elymsyr/mysterychain/interfaces/watch/README.md

# Watch (device firmware)

One Arduino sketch for the keychain's round display: [`firmware/firmware.ino`](firmware/firmware.ino). The scene is a header next to it, picked by the `#include` line near the top of the sketch. The default, [`pets.h`](firmware/pets.h), holds all three pets (cat, Pavi, Nausicaa) and lets the phone switch between them (`#set scene`, the app's settings); the choice is saved on the board.

| Scene header | What happens |
| --- | --- |
| [`cat.h`](firmware/cat.h) | Pixel cat on a lawn. Shake: the yarn ball flies, the cat jumps and plays for 6 s. The cat is also a pet, see [Pets](#pets). |
| [`pavi.h`](firmware/pavi.h) | Pavi (Seven Havens) on a wall above the rooftops: clouds and sun by day, aurora, moon and stars at night. Shake: her fairy darts off and she chases it. Pavi is also a pet, see [Pets](#pets). |
| [`nausicaa.h`](firmware/nausicaa.h) | Nausicaa in a windy valley with Teto on her shoulder. Shake: Teto jumps off, she tries to catch him, then kneels and he climbs back. |

Every scene behaves the same way (screens: [docs/mockups/device_screens.png](../../docs/mockups/device_screens.png)):

- 80×80 pixel scene, scaled 3× to the 240×240 display over SPI DMA, ~30 fps. Motion is tied to real time, so speed holds if fps drops.
- **BLE** (Nordic UART, name `MysteryChain`): text from the [mobile app](../mobile-app/) scrolls in a speech bubble at the top, the motor buzzes twice, the character cheers. Messages starting with `#` are commands, see [protocol](#protocol).
- **Clock:** the app sends the phone's time on every connect. Kept until power-off; after that it's back on the next connect.
- **Button** (D0): the character cheers, motor buzzes once, `button N` is sent to the phone. Once the clock is set, a tap also shows the time (`14:32`) in the bubble for 3 s.
- **Find** (`#find`): `FIND ME!` in the bubble, the motor buzzes twice and pauses, the screen colors invert twice a second. A button press stops it and sends `found`; `#find 0` stops it from the app; after `FIND_MS` (60 s) it stops by itself and sends `find timeout`. Shakes are ignored while it runs.
- **Power** (button in firmware; the battery switch on the back stays on): hold the button 3 s to turn off (display cut by Q2 on D7, System OFF, a few µA). Hold ~1 s to turn on; a short tap leaves it off. Plugging in USB also turns it on, so uploads work with the case closed. Waking is a reset: the scene starts over.
- **Screen off:** no button for 20 s (pets: 30 s, 1 or 5 min, `#set screen`): the display goes dark (Q2 cut), BLE stays up. Motion never keeps it lit: a keychain moves all day, and in the pocket it kept the screen on. What wakes it (pets: `#set wake`, any of button / shake / lift; other scenes: the button): shake is the IMU's wake-up function over the shake threshold, lift its tilt function (> 35°), both latched and checked every dark loop (up to `DARK_WAIT_MS` late); either one also fires in a moving pocket. Dark, the board sleeps up to `DARK_WAIT_MS` (1 s) at a time, the button wakes it at once, the accelerometer drops to 26 Hz low power (the pedometer still counts; no shakes or petting while dark), and it asks the phone for slave latency (`BLE_DARK_LATENCY`), so the radio wakes ~every 240 ms instead of 30. The button or `#find` brings it back. Turned off with the button, only the button turns it on (IMU unpowered in System OFF).
- **Radio:** −4 dBm. Unconnected, it advertises every 20 ms for 30 s, then every 1 s.
- **Battery** ([`battery.h`](firmware/battery.h)): a gauge at the bottom of the screen for `CLOCK_MS` after a tap, always while on USB (bolt; yellow and filling = charging, green and full = done) or below 15 % (red). The level comes from a LiPo curve, read every 5 s, not during a buzz. Without USB below `VBAT_OFF_MV` (3.4 V) it turns itself off; the button turns it on again only to go off once more until it's charged. PC check: `g++ -std=c++17 -I firmware test/battery_test.cpp -o /tmp/battery_test && /tmp/battery_test /tmp/battery.ppm` (the `.ppm` shows the four looks).
- **Shake** (IMU): the scene reacts, `shake N (x.xx g)` is sent to the phone. Shakes are ignored for `MOTOR_MASK_MS` after the motor stops.
- Serial monitor prints fps once a second.

## Pets

With `cat.h` or `pavi.h` the character lives on its own: stats, moods, day and night, a runner game, a music screen. Both have the same set of animations, each in its own way (below: cat / Pavi). Screens: [day and night](../../docs/mockups/pet_day_night.png), [animations](../../docs/mockups/pet_animations.png), [game](../../docs/mockups/pet_game.png); every animation as a clip: [preview](#preview).

- **Stats** ([`pet.h`](firmware/pet.h)): fullness, happiness, energy, 0–100, kept on the board only to pick the animations (not shown anywhere). Fullness empties in 10 h (half as fast asleep), happiness in 16 h awake (twice as fast when starving), energy in 16 h awake and refills in 8 h of sleep. Messages and reactions +8 (once a minute), petting +5, 100 steps +1, a game up to +15 and −10 energy. The pet never dies.
- **Mood**, first that holds: `sleep` (night window or energy < 10), `hungry` (< 25), `sad` (< 25), `tired` (< 25), `happy`. Asleep: curled up with z's / hugging her knees, the fairy dozing on her head. Hungry: by an empty bowl / plate. Sad: lies down / sits with her head down. Tired: yawns. Happy: now and then a butterfly (day) or a mouse / firefly (night) comes by and gets chased; every 10–25 s an idle trick: grooming or a tail chase / a wave, sitting with her feet tapping, or a twirl.
- **Button:** tap = clock + cheer (after 300 ms); double tap = feed (after 300 ms with `pets.h`); triple tap (`pets.h`) = next character, its name in the bubble (eats from the bowl / an apple, or shakes the head when fullness > 90); hold until the 1 s buzz and release = runner game; hold 3 s = off.
- **Music screen:** while the phone plays music (`#music`), the whole background turns into the character's own gradient (cat: peach to plum, Pavi: pink to violet), the title scrolls across the top and the character dances to a 120 bpm beat, notes rising. No buzz. It stays while the music plays; paused (`#music 0`) the title stays and the dancing stops for `MUSIC_PAUSE_MS` (60 s), then it's gone (also when the link drops). On it the button is a media key: tap = play/pause (`media toggle`), double tap = next track (`media next`); triple tap, hold and the 3 s off work as usual. A message or the clock shows over it for its time, find and the game end it, a shake is a hop and back to dancing. Asleep, the pet sleeps on.
- **Runner game:** tap = jump over a flower pot, hold = high jump over a fence, stay down under birds (from 20 points). Score and best in the bubble; a new best buzzes 3 times. Each character keeps its own best (the app shows them and resets them). After a game over a press restarts, 10 s idle or a 3 s hold leaves (no power-off inside the game). Not with energy < 15.
- **Pavi's game** (instead of the runner): the travel road, seen from behind her. Tilt the keychain right / left = right / left lane, level = middle; the button isn't used. One hit and it's over, score = obstacles passed, faster every 5 points. Tilt axis and sign: `TILT_AXIS` / `TILT_SIGN` in `firmware.ino` (check on the device), thresholds `TILT_IN` / `TILT_OUT` in `pavi.h`.
- **Nausicaa's game** (instead of the runner): an air fight on the Mehve, seen from above, the valley (fields, a river, woods) rolling under her. Tilt sets where she flies along the bottom (level = middle, `TILT_FULL` 0.5 g = the edge); the button fires, held = auto-fire. Every shot heats the gun (bar under her: green, amber, red); full heat jams it, blinking, until it has cooled all the way (~1.4 s). Planes from the top: Pejite gunships (red, weaving, ram you, 1 hit), Tolmekian armored corvettes (four wings, aimed shots, 3 hits, from 5 points), Bumblecrow transports (huge, 3-way spread, 8 hits, from 15 points). A bullet or a crash ends it; a downed plane scores its hits. Her shots end at the bubble's lower edge, so every fight is in view. Tunables at the game section of `nausicaa.h`.
- **Gandalf and Sauron** ([`gandalf.h`](firmware/gandalf.h), [`sauron.h`](firmware/sauron.h)) are full pets too, with the same moods and events. Gandalf: asleep standing on his staff, nodding, z's; hungry: peers into an empty tankard and shakes the last drop out; sad: head down, sighing; tired: yawns; fed: drinks an ale (foam moustache); full: waves it off, shaking his head; petted: chuckles. Music screen: he rides Shadowfax across Rohan (side on, parallax peaks / downs / road, dust from the hooves; shake = a leap, tap = the staff lights). Sauron: asleep, the Eye on the tower shut and the visor down to embers; hungry: holds up an empty goblet, drums his mace; sad: the Eye dims, smoke sighs from the visor; fed: a goblet of lava to the visor; full: waves it away; petted: a laugh, the visor flashing. Music screen: he flies a fell beast over Gorgoroth (ash clouds, the Ephel Dúath, smoking cones, lava cracks, Barad-dûr passing far off; shake = a climb, tap = the beast shrieks). Both set off on a ride / flight of their own now and then when happy. Their games: the Bridge of Khazad-dûm / the Ring's maze (see the headers). Clips: [`test/lotr_preview.cpp`](test/lotr_preview.cpp) (`-DSAURON`).
- **Petting:** double tap on the case (IMU tap engine): hearts and a soft purr buzz. A shake waits 300 ms so a double tap isn't taken as a shake.
- **Steps:** the IMU's hardware pedometer; today's count resets at local midnight. Off = no counting.
- **Day and night:** sky, ground, clouds, sun and moon follow the clock (dawn 06–08, day, sunset 18–20, night; keyframes in `pet.h`, colors per scene in its `LOOK` table). Pavi: the aurora and stars fade in at night, her rooftops fade into the haze by day and their windows light up in the evening. No clock yet: night look.
- **Weather** (`#weather`, the phone's forecast for the next 4 hours; drawn by [`weather.h`](firmware/weather.h), shared by the three): clear, cloudy, wind, rain, snow or storm. The sky greys over and fills with clouds (wind: they race), the stars, aurora, sun and moon go behind them; rain and snow fall, snow settles on the ground (roofs, ridges), a storm sends a bolt with one 0.08 s flash every 4–10 s (never a strobe). The pets follow it, cat / Pavi / Nausicaa:
  - rain: sits under a planted umbrella / holds a water dome over herself, the fairy inside / sits under a big leaf;
  - snow: paws at the flakes and leaps / catches one and it sparkles / catches them, or Teto leaps off to play in the snow;
  - clear and the sun up: sunbathes in shades / sits in the sun, eyes shut (both);
  - wind: a blown leaf comes by instead of a butterfly, tail / ponytail / hair stream out, squinting in a gust; Pavi's fairy fights the gusts, Nausicaa's windmills spin fast and she reads the wind more often;
  - thunder startles them (puffed up / hands to the head, Teto hides in her tunic); asleep, one eye opens.
  The clock tap shows the weather's icon left of the time. No new forecast for `WX_MS` (4 h): unknown again (clear look, no icon). The games have no weather.
- **Night window** (default 23–07): the pet sleeps and the motor is quiet, except for find.
- **Saved** in the internal flash (`/pet`, LittleFS) every 10 min and on feed, settings, a new best and power-off. Time spent off counts as sleep (up to 48 h) once the phone sends the time.

## Flash

Arduino IDE 2 with **Seeed nRF52 Boards** (non-mbed), board **Seeed XIAO nRF52840 Sense**, libraries **Adafruit GC9A01A** and **Seeed Arduino LSM6DS3**. Full setup: [electronics/bring-up.md](../../electronics/bring-up.md#phase-0-tools-and-software).

Open `firmware/firmware.ino`, upload (to flash a single scene instead, set it in the `#include` line). Or with arduino-cli:

```bash
arduino-cli compile --fqbn Seeeduino:nrf52:xiaonRF52840Sense --upload -p /dev/ttyACM0 firmware
```

Tunables at the top of `firmware.ino`:

| Constant | Default | Meaning |
| --- | --- | --- |
| `SPI_HZ` | 32 MHz | Display clock. Drop to 16 MHz (~17 fps) if the image glitches. |
| `SHAKE_G` | 0.5 | Shake threshold: deviation of \|a\| from 1 g |
| `SHAKE_GAP_MS` | 400 | Minimum time between two shakes |
| `MOTOR_MASK_MS` | 400 | Shake blackout after the motor stops. Use the value measured in bring-up T8. |
| `ON_HOLD_MS` / `OFF_HOLD_MS` | 1000 / 3000 | Button hold to turn on / off |
| `IDLE_OFF_MS` | 20000 | Screen off after this long without the button (pets: `#set screen` instead) |
| `DARK_WAIT_MS` | 1000 | Screen off: longest sleep between loops (the button wakes it sooner) |
| `BLE_DARK_LATENCY` | 7 | Screen off: 30 ms connection events the radio may skip |
| `CLOCK_MS` | 3000 | How long a button tap shows the time |
| `MUSIC_PAUSE_MS` | 60000 | Pets: paused music keeps its screen this long, so a tap can resume it |
| `FIND_MS` | 60000 | Find stops by itself after this long |
| `GAME_HOLD_MS` | 1000 | Pets: hold and release after this long = game |
| `TAP_WAIT_MS` | 300 | Pets: a tap waits this long for a second one (double = feed) |
| `SHAKE_WAIT_MS` | 300 | Pets: a shake is decided this late; a case double tap inside it is petting |
| `TAP_GUARD_MS` | 500 | Pets: case taps this soon after a button edge are ignored |
| `TAP_THS` | 1 | Pets: IMU tap threshold, × 0.5 g. Check through the printed case |
| `SAVE_S` | 600 | Pets: stats saved this often |
| `WX_MS` | 4 h | Pets: a forecast (`#weather`) is dropped this long after it came |

Stat rates and gains are at the top of [`pet.h`](firmware/pet.h), game physics at the top of [`game.h`](firmware/game.h).

## Protocol

Plain UTF-8 text over Nordic UART. A message ends at a line break (the app sends one), or 150 ms after its last byte for senders without one, so a write split into 20-byte packets on a small MTU still arrives as one message. A message the board doesn't recognise as a command shows in the bubble, so plain text, and text that only looks like a command (`#1 fan`), keeps working.

| Phone → keychain | Effect |
| --- | --- |
| any text | Bubble (max 63 characters; Turkish letters folded to ASCII, other non-ASCII shows as `?`), buzz twice, cheer |
| `#time <unix s> <utc offset min>` | Set the clock. The app sends it on every connect. |
| `#find` / `#find 0` | Start / stop find |
| `#heart` | Three pink hearts in the bubble, buzz twice, cheer |
| `#call <caller>` / `#call 0` | A call rings: caller in the bubble, ring buzz (0.4 s every second) / answered or gone: bubble and buzz stop. Stops by itself after `CALL_MS` (45 s). Sent by the app's background link. |
| `#music <title - artist>` / `#music 0` | A track plays / music paused or stopped: pets show the [music screen](#pets) while it plays, other scenes ♫ and the text in the bubble. No buzz. Sent by the app's background link on every change and on connect. |
| `#weather clear\|cloudy\|wind\|rain\|snow\|storm` | Pets: the weather for the next hours ([pets](#pets)); anything else (`#weather 0`) = unknown. Not saved; dropped after `WX_MS`. The app sends it on connect and every hour. |
| `#feed` | Pets: feed (answers `fed` or `full`) |
| `#stats` | Pets: send `stats` now |
| `#set vib 0\|1` | Pets: motor off / on (find always buzzes) |
| `#set shake <g>` | Pets: shake threshold, 0.3–1.0 |
| `#set screen 30\|60\|300` | Pets: screen off after this many s without the button |
| `#set wake <bits>` | Pets: what wakes the dark screen, 1 button + 2 shake + 4 lift (1–7) |
| `#set night <from h> <to h>` | Pets: night window (sleep + quiet); `from == to` = none |
| `#set name <look> <text>` | `pets.h`: that look's own name, up to 12 characters (defaults `Cat`, `Pavi`, `Nausicaa`); a single-scene build takes `#set name <text>` |
| `#set scene cat\|pavi\|nausicaa` | `pets.h`: the pet's look, at once and saved. Stats are shared, each look has its own name and high score; a running game ends |
| `#set best <look>\|all` | Pets: that look's high score (or all of them) back to 0 |

| Keychain → phone | When |
| --- | --- |
| `button N` | Button pressed (N counts since boot) |
| `shake N (x.xx g)` | Shake detected |
| `found` | Button pressed during find |
| `media toggle` / `media next` | Pets: button tap / double tap on the music screen; the app plays/pauses or skips the playing session |
| `find timeout` | Find stopped by itself after `FIND_MS` |
| `stats <steps> <mood> <battery %>` | Pets: after `#time`, on `#stats`, after a feed, and once a minute if a value changed; battery -1 = on USB |
| `settings vib=<0\|1> shake=<g> night=<from>-<to> screen=<s> wake=<bits> scene=<look> name=<cat>\|<pavi>\|<nausicaa>` | Pets: after `#time` and every `#set`; one name per look in `pets.h` order (a single-scene build sends one) |
| `fed` / `full` | Pets: answer to a feed (button or app) |
| `best <cat>\|<pavi>\|...` | Pets: right after every `settings`; each look's high score in `pets.h` order (a single-scene build sends one) |
| `game <score> best <best>` | Pets: game over |

## Scene interface

Each scene header (`cat.h`, `pavi.h`, `nausicaa.h`) is plain C++ with no Arduino dependency, so it can be compiled on a PC and dumped frame by frame. It lives in its own namespace, ends with `namespace scene = <its namespace>;` (the sketch only talks to `scene::`) and exposes:

| Name | Purpose |
| --- | --- |
| `N`, `fb[N*N]` | Scene size and the color-indexed framebuffer |
| `PAL[NCOL][3]`, `NCOL` | RGB palette |
| `INK`, `CREAM` | Palette indices used by the speech bubble |
| `px(x, y, c)` | Set one pixel (clipped) |
| `init()` | Draw the static background |
| `step(dt)` | Advance by `dt` seconds and redraw `fb` |
| `shake()` | React to a shake |
| `cheer()` | React to a message or button press |

To add a scene, put its header in `firmware/` with the same interface and the `namespace scene = …;` line, and include it from `firmware.ino`. The sketch adds four palette entries after the scene's own: `NCOL` pink for the hearts, `NCOL + 1..3` the weather icon's grey, blue and yellow.

A scene that ends with `#define SCENE_PET` (`cat.h`, `pavi.h`) turns on the pet code in the sketch and also exposes: `PAL` writable plus `tint(minuteOfDay)`, `setMood()`, `eat()`, `refuse()`, `purr()`, `yawn()`, `music(on)` (called every frame), and the game (`game`, `gameStart()`, `gameInput(held)`, `gameTilt(g)`, `gameStop()`, `gameLabel()`). Stats and the time-of-day keyframes live in [`pet.h`](firmware/pet.h); the runner in [`game.h`](firmware/game.h), included by the cat (Pavi and Nausicaa have their own tilt games in their headers) (its header lists what a scene defines for it: the `hero`, its head span, the bird height). PC check for both, with either runner:

```bash
g++ -std=c++17 -I firmware test/pet_test.cpp -o /tmp/pet_test && /tmp/pet_test
g++ -std=c++17 -DPAVI -I firmware test/pet_test.cpp -o /tmp/pet_test && /tmp/pet_test
g++ -std=c++17 -DPETS -I firmware test/pet_test.cpp -o /tmp/pet_test && /tmp/pet_test   # pets.h look switch
```

[`pets.h`](firmware/pets.h) includes the three pet headers (they skip their `namespace scene` alias when `SCENE_PICK` is defined) and is itself the `scene`: `fb`, `PAL`, `NCOL`, `INK`, `CREAM` point at the current look, the calls go to it, `pick(i)` switches. The runner state is one object for all (`pet::runner`).

### Preview

[`test/preview.cpp`](test/preview.cpp) runs a pet scene on the PC and dumps a clip of every animation (times of day, music screen, moods, visitors, idle tricks, every weather `wx_*` and the clock icons, the game on autopilot); [`test/preview.py`](test/preview.py) turns them into round-masked GIFs. Look at them before flashing:

```bash
cd test
g++ -std=c++17 -O2 -I../firmware -I ~/Arduino/libraries/Adafruit_GFX_Library preview.cpp -o /tmp/preview_cat   # -DPAVI, -DNAUSICAA
mkdir -p /tmp/clips && /tmp/preview_cat /tmp/clips && python3 preview.py /tmp/clips /tmp/gifs   # --sheet: contact sheets too
python3 gallery.py [cat pavi nausicaa gandalf sauron]   # all of the above for every character, one page in the browser
```

## Rules for new animations

1. Existing behaviors stay as they are (cat `IDLE` / `RUN` / `CROUCH` / `JUMP` / `LAND` / `BAT`, Pavi and the fairy, yarn physics, `shake()` and `cheer()` reactions). New animations are added next to them, for both pets.
2. For every animation, write down when it starts, how long it lasts, which state it returns to and which events interrupt it.
3. Animations read the pet stats (hunger, happiness, energy) to pick what to play, and change them (eating lowers hunger, play costs energy). See [roadmap](../../docs/roadmap.md) K1.
4. They follow the time of day and weather backgrounds; characters and props must stay readable on every background, including night colors. At night the default is sleep.
5. Events can interrupt any animation: message/notification bubble, "find" command, shake, petting, button. A sleeping pet wakes up when shaken.
6. Motion uses `dt`, never frame counts.
7. Logic and drawing stay separate: stats and clock keep running while the display is off; drawing only happens when it's on.
8. Limits: 80×80 indexed buffer with the scene palette, ~30 fps target, the top band (y 11–24) is reserved for the speech bubble, corners are invisible on the round screen.
