elymsyr/mysterychain/electronics/schematic/schematic_pnp_white.png

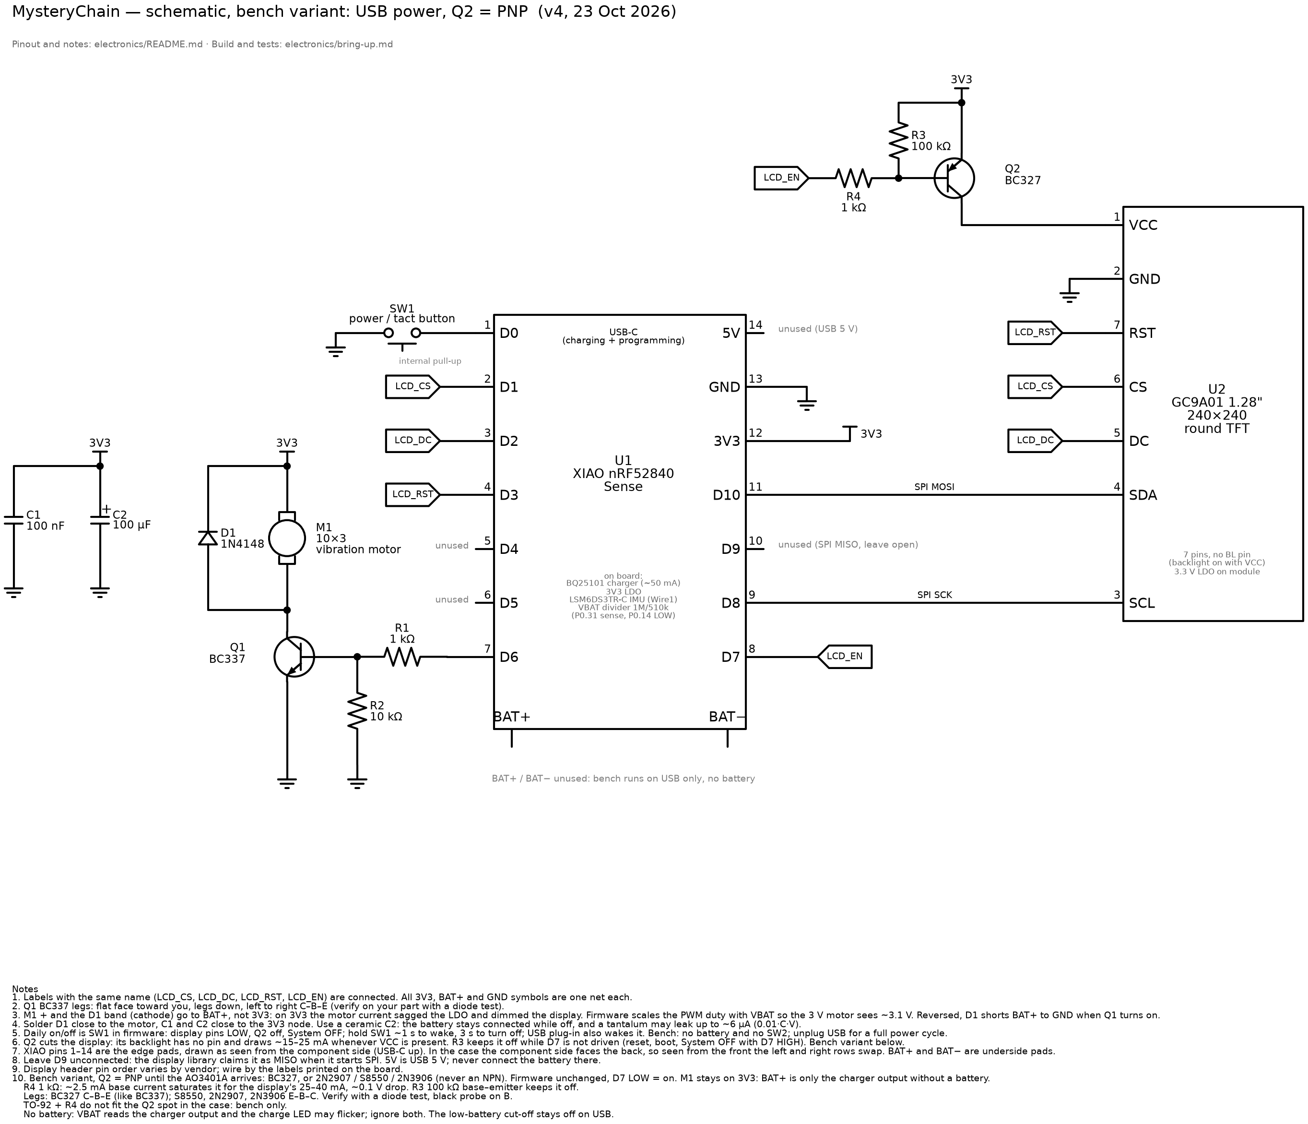
electronics/schematic/schematic_pnp_white.png
