elymsyr/mysterychain/electronics/schematic/schematic_proto_white.png

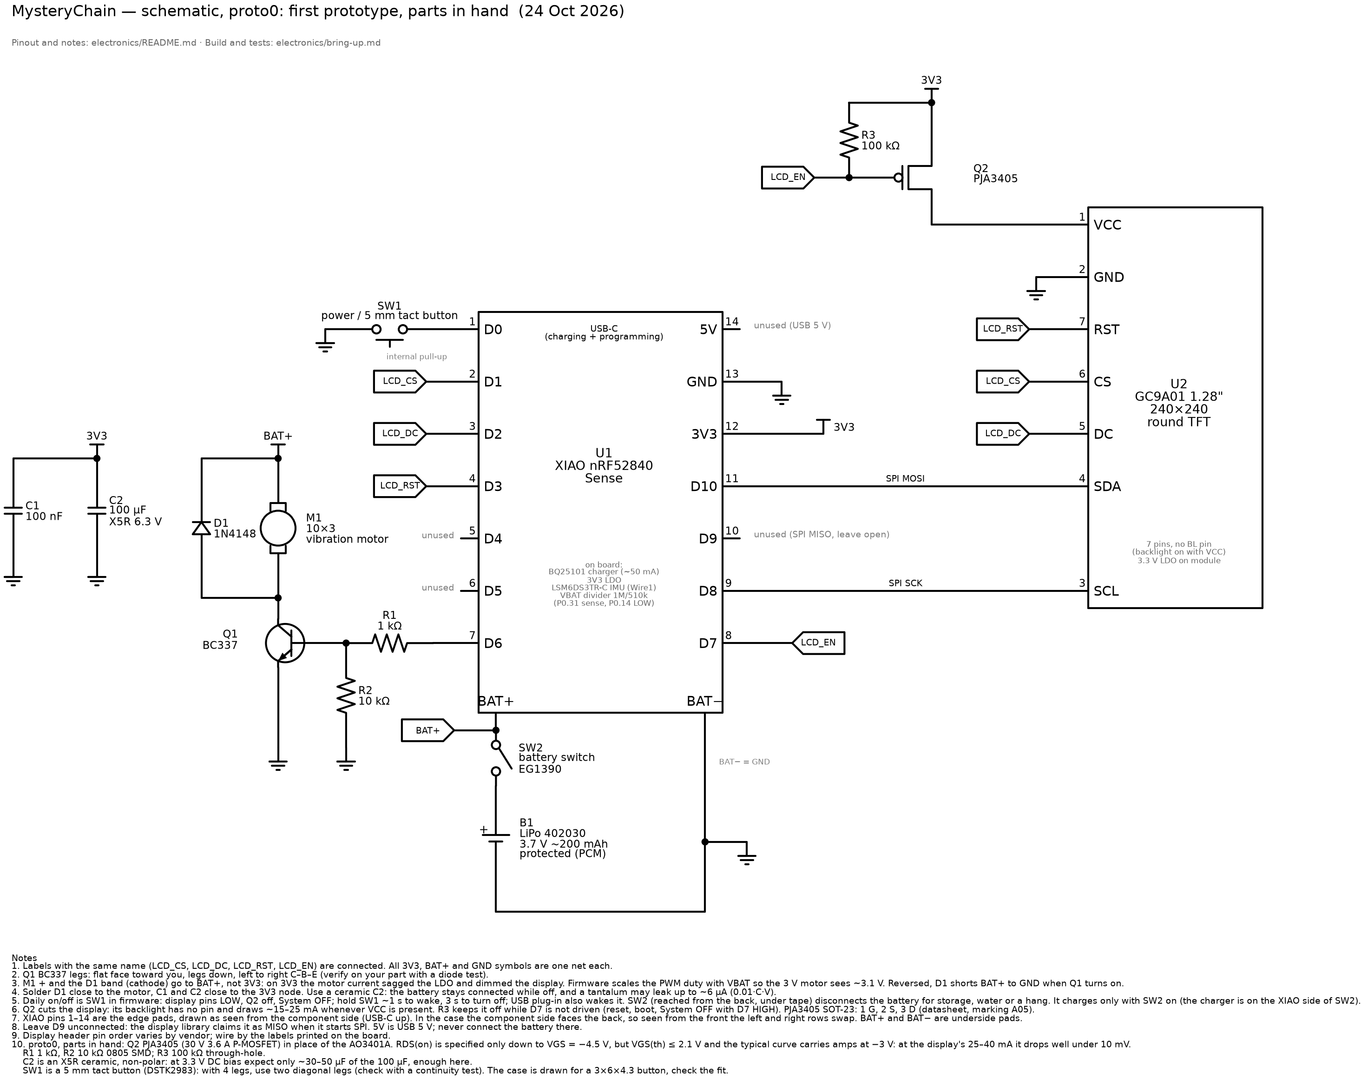
electronics/schematic/schematic_proto_white.png
