elymsyr/mysterychain/mechanical/parts/gc9a01_teyleten_nopins.step

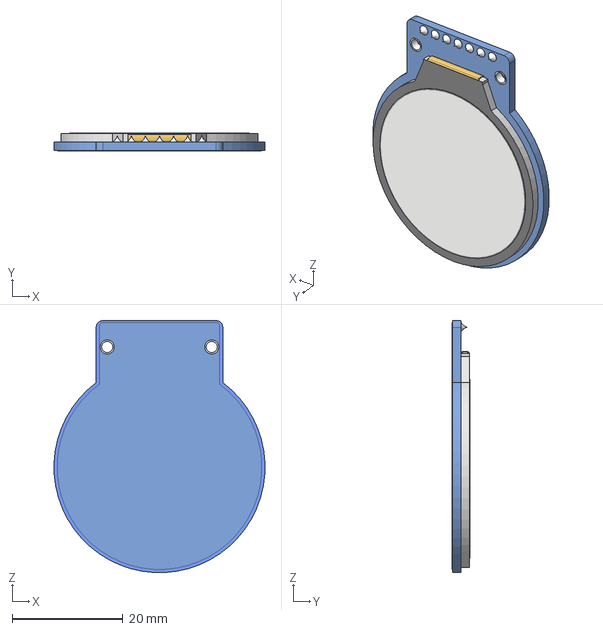
[picture p8: CAD file, 2026-10-14]
mechanical/parts/gc9a01_teyleten_nopins.step
38.1 x 3.24 x 45.5 mm
