elymsyr/mysterychain/mechanical/pet_case.step

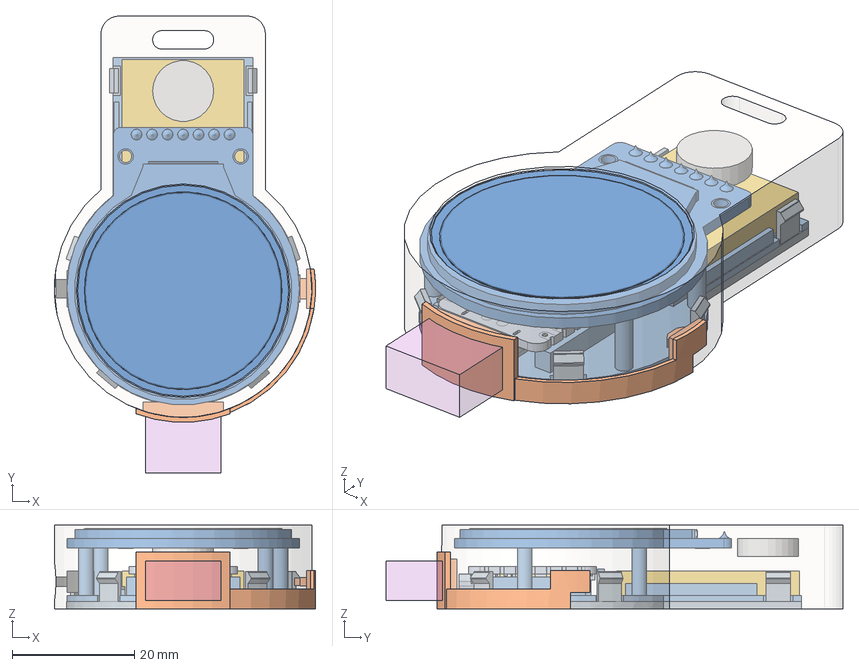
[picture p9: CAD file, 2026-10-20]
mechanical/pet_case.step
42.8 x 74.9 x 13.7 mm
front_housing
midframe
back_cover
usb_plug_tpu
gc9a01_display_module
xiao_nrf52840_sense
xiao_header_pins
vibration_motor
tact_button
lipo_402030
battery_switch_eg1390
battery_safe_zone
passives_zone
q2_zone
usb_c_plug_overmold
