elymsyr/mysterychain/mechanical/print/front_housing.3mf

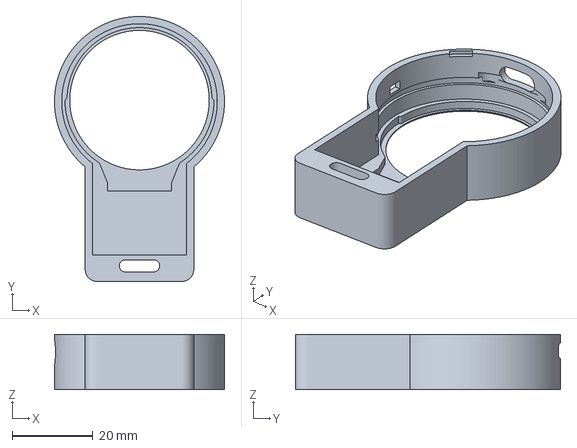
[picture p10: CAD file, 2026-10-24]
mechanical/print/front_housing.3mf
42.2 x 65.8 x 13.7 mm
