elymsyr/mysterychain/mechanical/parts/gc9a01_teyleten.step

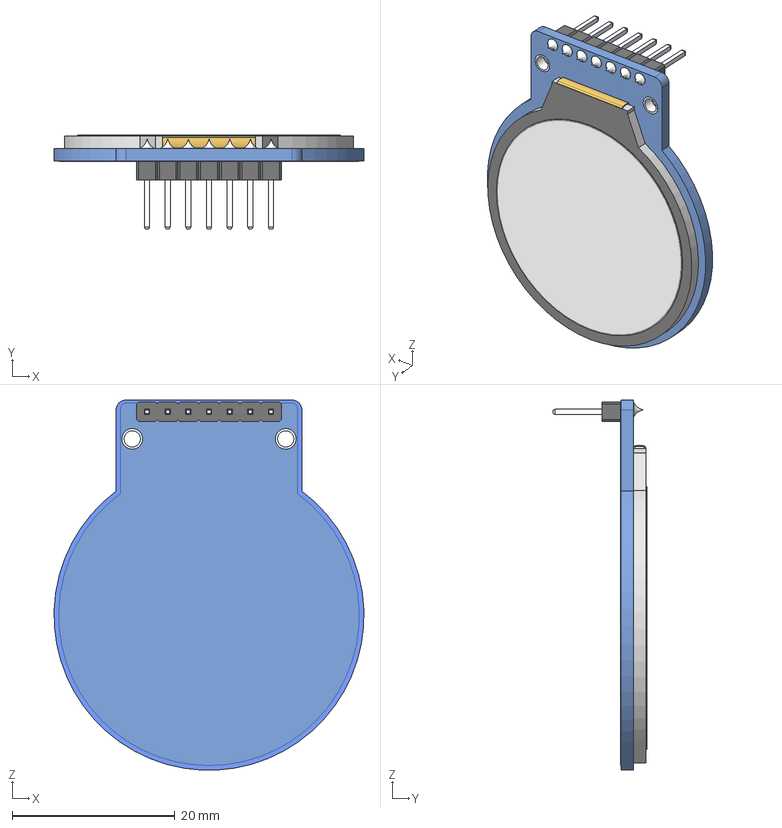
[picture p11: CAD file, 2026-10-14]
mechanical/parts/gc9a01_teyleten.step
38.1 x 11.5 x 45.5 mm
