elymsyr/mysterychain/mechanical/print/back_cover.3mf

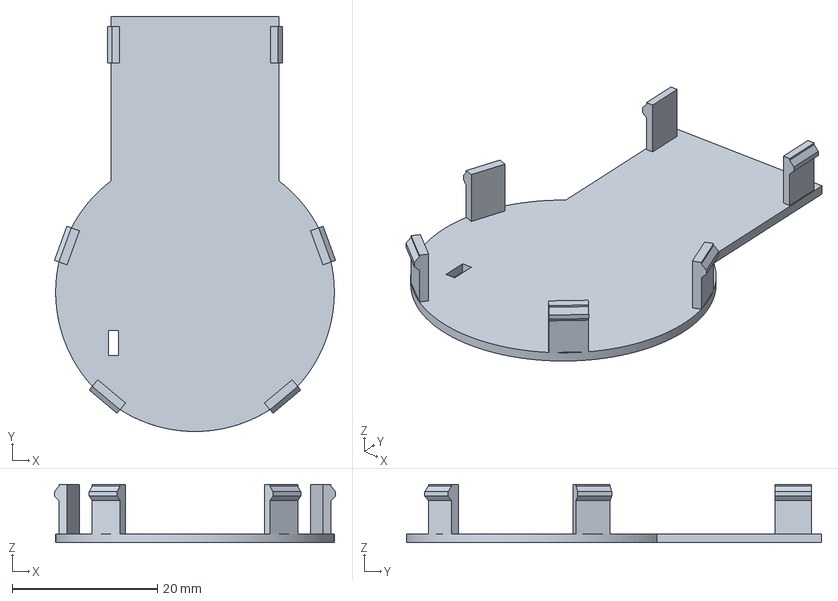
[picture p12: CAD file, 2026-10-24]
mechanical/print/back_cover.3mf
38.7 x 57.2 x 8.00 mm
