elymsyr/mysterychain/mechanical/print/midframe.3mf

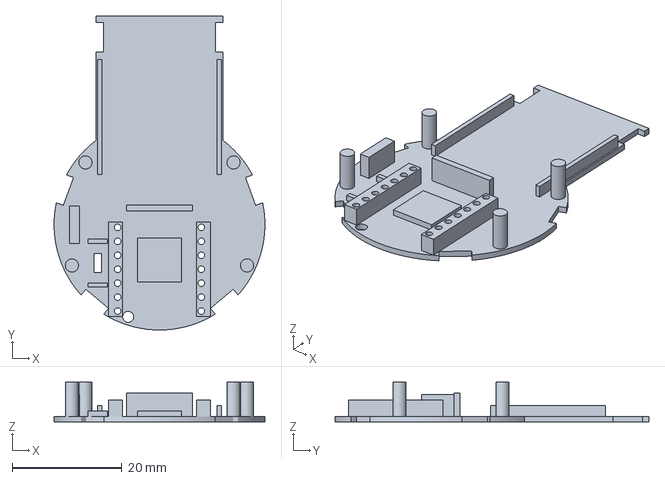
[picture p14: CAD file, 2026-10-24]
mechanical/print/midframe.3mf
38.4 x 57.2 x 7.26 mm
