elymsyr/mysterychain/(list of files, cad)

Other CAD files:
mechanical/print/versions/chain.gcode.05.gcode.3mf
mechanical/print/versions/chain.gcode.06.gcode.3mf
mechanical/print/versions/chain.gcode.04.gcode.3mf
mechanical/print/versions/chain.gcode.02.gcode.3mf
mechanical/print/versions/chain.gcode.03.gcode.3mf
mechanical/print/versions/chain.gcode.01.gcode.3mf
mechanical/print/versions/chain.gcode.3mf
mechanical/pet_case.dxf
mechanical/print/back_cover.stl
mechanical/print/front_housing.stl
mechanical/print/midframe.stl
