elymsyr/mysterychain/mechanical/renders/print_back_cover.png

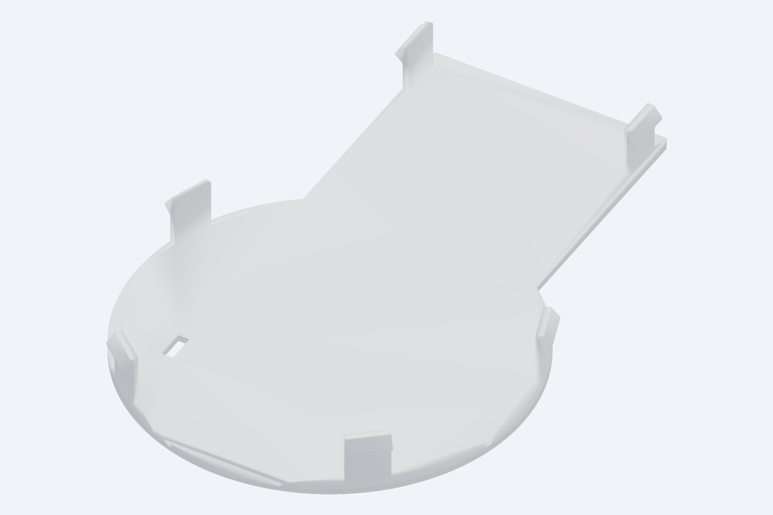
mechanical/renders/print_back_cover.png
