elymsyr/mysterychain/mechanical/renders/print_front_housing.png

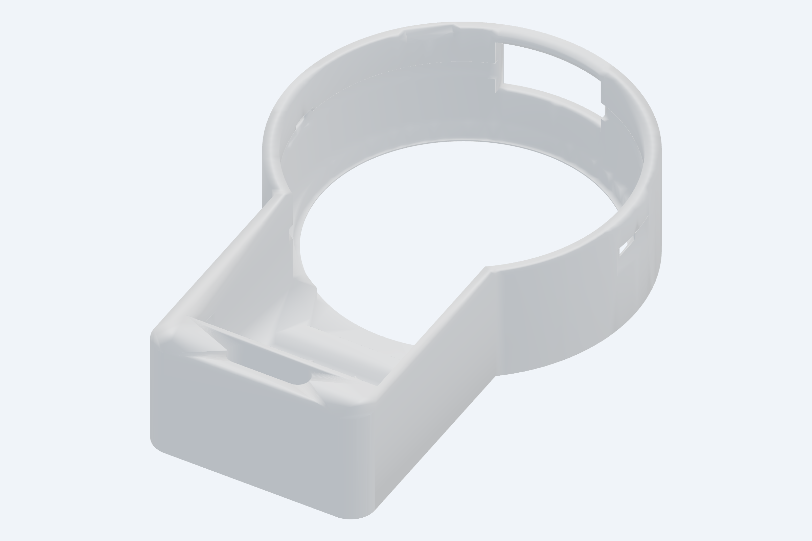
mechanical/renders/print_front_housing.png
