elymsyr/mysterychain/mechanical/renders/print_midframe.png

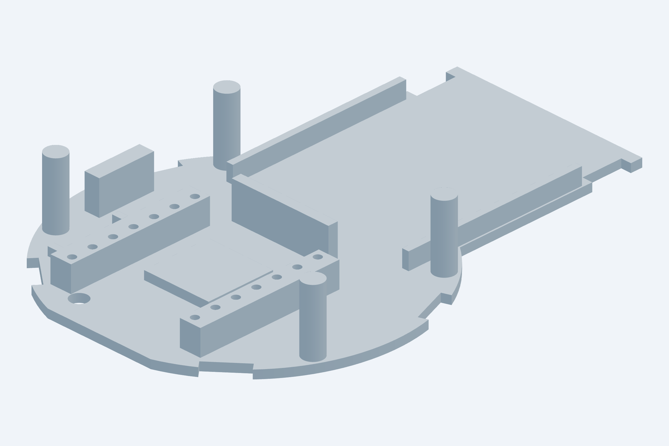
mechanical/renders/print_midframe.png
