elymsyr/mysterychain/interfaces/watch/firmware/pets.h

// All five pets in one firmware, the look picked from the phone (#set scene cat|pavi|nausicaa|gandalf|sauron, saved in /pet):
// firmware.ino talks to this `scene` as it would to a single scene header. Stats and high score are shared; each
// character keeps its own name (pet::s.names).
#pragma once
#define SCENE_PICK
#include "cat.h"
#include "pavi.h"
#include "nausicaa.h"
#include "gandalf.h"
#include "sauron.h"

namespace scene {

const int N = 80;
static_assert(kitty::N == N && pavi::N == N && nausicaa::N == N && gandalf::N == N && sauron::N == N, "all scenes draw the same buffer size");
const char *const NAMES[] = {"cat", "pavi", "nausicaa", "gandalf", "sauron"};
const int COUNT = 5;
static_assert(COUNT <= pet::LOOKS, "a saved name per look");

uint8_t cur = 0;  // 0 cat, 1 Pavi, 2 Nausicaa, 3 Gandalf, 4 Sauron
// The current scene's buffer, palette and the bubble colors (pick() rebinds them).
uint8_t *fb = kitty::fb;
uint8_t (*PAL)[3] = kitty::PAL;
uint8_t NCOL = kitty::NCOL, INK = kitty::INK, CREAM = kitty::CREAM;
pet::Game &game = pet::runner;

inline uint8_t *view() { return cur == 4 ? sauron::view() : cur ? fb : kitty::view; }  // what goes on screen: the cat's game has a wider one, Sauron's a finer one
inline int viewN() { return cur == 4 ? sauron::viewN() : cur ? N : kitty::VN; }
inline void px(int x, int y, uint8_t c) { cur == 4 ? sauron::px(x, y, c) : cur == 3 ? gandalf::px(x, y, c) : cur == 2 ? nausicaa::px(x, y, c) : cur ? pavi::px(x, y, c) : kitty::px(x, y, c); }
void init() { kitty::init(), pavi::init(), nausicaa::init(), gandalf::init(), sauron::init(); }
void step(float dt) { cur == 4 ? sauron::step(dt) : cur == 3 ? gandalf::step(dt) : cur == 2 ? nausicaa::step(dt) : cur ? pavi::step(dt) : kitty::step(dt); }
void shake() { cur == 4 ? sauron::shake() : cur == 3 ? gandalf::shake() : cur == 2 ? nausicaa::shake() : cur ? pavi::shake() : kitty::shake(); }
void cheer() { cur == 4 ? sauron::cheer() : cur == 3 ? gandalf::cheer() : cur == 2 ? nausicaa::cheer() : cur ? pavi::cheer() : kitty::cheer(); }
void tint(int m) { cur == 4 ? sauron::tint(m) : cur == 3 ? gandalf::tint(m) : cur == 2 ? nausicaa::tint(m) : cur ? pavi::tint(m) : kitty::tint(m); }
void setMood(pet::Mood m) { kitty::setMood(m), pavi::setMood(m), nausicaa::setMood(m), gandalf::setMood(m), sauron::setMood(m); }
void eat() { cur == 4 ? sauron::eat() : cur == 3 ? gandalf::eat() : cur == 2 ? nausicaa::eat() : cur ? pavi::eat() : kitty::eat(); }
void refuse() { cur == 4 ? sauron::refuse() : cur == 3 ? gandalf::refuse() : cur == 2 ? nausicaa::refuse() : cur ? pavi::refuse() : kitty::refuse(); }
void purr() { cur == 4 ? sauron::purr() : cur == 3 ? gandalf::purr() : cur == 2 ? nausicaa::purr() : cur ? pavi::purr() : kitty::purr(); }
void yawn() { cur == 4 ? sauron::yawn() : cur == 3 ? gandalf::yawn() : cur == 2 ? nausicaa::yawn() : cur ? pavi::yawn() : kitty::yawn(); }
void music(bool on) { cur == 4 ? sauron::music(on) : cur == 3 ? gandalf::music(on) : cur == 2 ? nausicaa::music(on) : cur ? pavi::music(on) : kitty::music(on); }
void gameStart() { cur == 4 ? sauron::gameStart() : cur == 3 ? gandalf::gameStart() : cur == 2 ? nausicaa::gameStart() : cur ? pavi::gameStart() : kitty::gameStart(); }
void gameInput(bool held) { cur == 4 ? sauron::gameInput(held) : cur == 3 ? gandalf::gameInput(held) : cur == 2 ? nausicaa::gameInput(held) : cur ? pavi::gameInput(held) : kitty::gameInput(held); }
void gameStop() { cur == 4 ? sauron::gameStop() : cur == 3 ? gandalf::gameStop() : cur == 2 ? nausicaa::gameStop() : cur ? pavi::gameStop() : kitty::gameStop(); }
void gameTilt(float g) { cur == 4 ? sauron::gameTilt(g) : cur == 3 ? gandalf::gameTilt(g) : cur == 2 ? nausicaa::gameTilt(g) : cur ? pavi::gameTilt(g) : kitty::gameTilt(g); }
void gameTilt2(float right, float down) { cur == 4 ? sauron::gameTilt2(right, down) : void(); }  // both axes: the maze
void gameLabel(char *out, int cap) { cur == 4 ? sauron::gameLabel(out, cap) : cur == 3 ? gandalf::gameLabel(out, cap) : kitty::gameLabel(out, cap); }  // the rest read only the shared runner state

int find(const char *name) {  // index of a scene name, -1 = none
  for (int i = 0; i < COUNT; i++)
    if (!strcmp(name, NAMES[i])) return i;
  return -1;
}

// Switch the look. A running game ends; the firmware then retints and rebuilds its palette.
void pick(int i) {
  if (i < 0 || i >= COUNT) return;
  if (i != cur && game.on) gameStop();
  if (i != cur) music(false);
  cur = i;
  if (cur == 4) fb = sauron::fb, PAL = sauron::PAL, NCOL = sauron::NCOL, INK = sauron::INK, CREAM = sauron::CREAM;
  else if (cur == 3) fb = gandalf::fb, PAL = gandalf::PAL, NCOL = gandalf::NCOL, INK = gandalf::INK, CREAM = gandalf::CREAM;
  else if (cur == 2) fb = nausicaa::fb, PAL = nausicaa::PAL, NCOL = nausicaa::NCOL, INK = nausicaa::INK, CREAM = nausicaa::CREAM;
  else if (cur) fb = pavi::fb, PAL = pavi::PAL, NCOL = pavi::NCOL, INK = pavi::INK, CREAM = pavi::CREAM;
  else fb = kitty::fb, PAL = kitty::PAL, NCOL = kitty::NCOL, INK = kitty::INK, CREAM = kitty::CREAM;
}

}  // namespace scene
