elymsyr/mysterychain/(commit log)

2026-10-14 git init
    [back_cover.3mf, back_cover.stl, front_housing.3mf, front_housing.stl, gc9a01_teyleten.step, midframe.3mf, midframe.stl, pet_case.step]
2026-10-14 case design v4
    [back_cover.3mf, back_cover.stl, front_housing.3mf, front_housing.stl, gc9a01_teyleten_nopins.step, midframe.3mf, pet_case.step]
2026-10-14 case design technical drawings and print files
    [pet_case.dxf]
2026-10-15 case v7, switchless button power, tethered USB plug
    - Case v7: battery beside the XIAO in a full-depth lug (42.2 x 65.8 x 13.74),
    flat midframe and back cover, reset hole, Q2 spot, EG1390 battery switch
    under the back cover. v5/v6 archived. Print files and renders regenerated;
    2D drawings stay v6 (pet_case.dxf.py not ported yet).
    - New tethered TPU USB-C plug (usb_plug.step.py) in the old switch opening.
    - Electronics: Q2 AO3401A now required, SW2 in the battery line, schematic v3.
    - Firmware: button power on/off (hold 3 s off, ~1 s on, USB wakes) in all
    scenes; new T10 power test; T4/T8/T9 drive D7 LOW; motor pin held LOW.
    [back_cover.3mf, back_cover.stl, front_housing.3mf, front_housing.stl, midframe.3mf, midframe.stl, pet_case.dxf, pet_case.step]
2026-10-15 Add T11 Bench PNP variant code for display and motor control
    - Implemented USB power management with PNP transistor (BC327).
    - Added functionality for short and long button presses to control display and motor pulses.
    - Integrated serial monitor commands for display toggling, motor activation, and stress testing.
    - Included display initialization and state management to handle power dips.
    [t11_bench_pnp.ino]
2026-10-15 Single firmware sketch, clock/find/hearts protocol, dark app redesign
    - Merge the four scene sketches into watch/firmware/firmware.ino; the scene is
    picked by its #include (each header aliases namespace scene).
    - Protocol: #time, #find / #find 0, #heart; board sends button, shake, found,
    find timeout. Button tap shows the synced clock.
    - Find: buzz-buzz-pause + 2 Hz inverted palette, stops on button, app or 60 s.
    - App: flat dark theme, find/ring panel, quick reactions, activity log, clock
    sync on connect; dark launch screen.
    - Docs: protocol, roadmap (O1/A3/A4/A6 done, O2 deferred), mockups.
    [cat.h, firmware.ino, nausicaa.h, pavi.h]
2026-10-16 case v7.1: PLA test-fit fixes, drawings ported to v7
    - Hook groove 0.6 toward the front (z 4.0-6.2 -> 4.6-6.8) so the hooks
    preload the cover (test print sat 0.52 loose).
    - LCD neck/FPC pocket 1.0 larger all round (was +0.35).
    - pet_case.dxf.py ported to v7; DXF + drawing PDF regenerated.
    - Print files regenerated; add sliced chain.gcode.3mf.
    [back_cover.3mf, chain.gcode.3mf, front_housing.3mf, front_housing.stl, midframe.3mf, pet_case.dxf, pet_case.step, usb_plug.3mf]
2026-10-16 firmware: cat pet (K1-K7, S1, O2)
    - pet.h: fullness/happiness/energy stats, moods, LittleFS persistence.
    - game.h: one-button runner (tap/hold jump, birds from 20 points).
    - cat.h: day/night tint, mood animations, eat/refuse/purr/yawn, game hooks.
    - firmware.ino: button gestures (tap/double/hold), IMU tap petting,
    pedometer, #feed/#stats/#set commands, stats/settings/game reports.
    - test/pet_test.cpp: PC check for stats and game.
    - Not yet tested on hardware.
2026-10-16 app: pet name, steps, mood, feed and settings
    Header shows pet name, today's steps and mood (from stats <steps> <mood>);
    Feed button next to Find; settings sheet for name, vibration, shake
    threshold and night window. Multi-line notifications are split.
2026-10-16 docs: remove unused mockup images for app and device screens
2026-10-16 app: keep the keychain link in a foreground service
    One native GATT owner (KeychainService) paired through CompanionDeviceManager,
    woken by device presence; notification listener feeds calls and the playing
    track. Flutter drops flutter_blue_plus and is split into files with tests.
    Release builds are signed with a local keystore (key.properties, not in git).
2026-10-16 Add multi-pet support and time-of-day keyframes to pet firmware
    - Enhanced pet.h to include multiple pet names and a scene switcher for different looks (Cat, Pavi, Nausicaa).
    - Introduced a new pets.h file to manage all three pets, ensuring shared stats and high scores.
    - Added time-of-day keyframes for dynamic visual changes based on the time of day.
    - Updated pet_test.cpp to support testing for multiple pets and their interactions.
    - Created preview.cpp and preview.py for generating animation previews of pet scenes.
    - Included new image assets for Nausicaa's animations.
2026-10-16 app: add Pavi's tilt steering game and related functionality
2026-10-16 Refactor Nausicaa game mechanics and integrate new features
    - Updated Nausicaa's game to include a new air fight mechanic with planes and shooting.
    - Adjusted game physics for gravity, jump, and shooting mechanics to align with the new gameplay.
    - Enhanced the game visuals with new art assets for planes and bullets.
    - Implemented game logic for plane spawning, shooting, and collision detection.
    - Added autopilot functionality for automated gameplay in Nausicaa's game.
    - Modified existing code in related files (cat.h, game.h, firmware.ino) to accommodate new features and ensure compatibility.
    - Improved test coverage for Nausicaa's game mechanics, including tilt and shooting interactions.
    [cat.h, firmware.ino, game.h, nausicaa.h]
2026-10-20 firmware: Gandalf and Sauron draft scenes
    Two more looks (scenery only, pet calls are no-ops for now). pet.h
    VERSION 5 / LOOKS 5, so saved stats reset. test/lotr_preview.cpp renders them.
    [gandalf.h, pet.h, pets.h, sauron.h]
2026-10-20 app: weather from open-meteo and link on/off switch (0.3.0)
    Weather.kt pulls the next 4 h for the coarse location (or a chosen place)
    and sends the worst hour as #weather on connect and hourly; JUnit tests
    cover the rules. The pet page shows it under the header. Settings gain a
    switch that stops the keychain link entirely.
2026-10-20 case: LCD pocket clip half +0.5 mm (LCD_TOP_GROW)
    Regenerated STEP, DXF, drawing and print files.
    [back_cover.3mf, front_housing.3mf, front_housing.stl, midframe.3mf, pet_case.dxf, pet_case.step, usb_plug.3mf]
2026-10-20 print: add sliced chain plate
    [chain.gcode.01.gcode.3mf]
2026-10-20 case v7.2: hold the XIAO by its header pins in midframe rails
    Tape alone would creep under repeated USB-C plugging. Two pin rails on
    the midframe (x = +-6.75..+-9.3) with 2 x 7 holes (PIN_HOLE_D 0.9); the
    header pins (spacer off, 4.3 behind the PCB) press in and carry the
    plug force. Tape pad and stop rib kept.
    Drawings v7.2 (midframe note, BOM header row), README, bring-up
    (header now soldered for good, cut in phase 6), renders.
    [midframe.3mf, midframe.stl, pet_case.dxf, pet_case.step]
2026-10-20 Enhance pet game functionality and add self-check for Gandalf build
    - Introduced a new `buzz` variable in the Game struct to handle vibration pulses.
    - Added `palDirty` flag to indicate palette changes between retints.
    - Updated game handling functions to accommodate Gandalf's game logic, ensuring Sauron has no game interactions.
    - Implemented a self-check mechanism for the bridge game, including a bot that plays the game and asserts expected outcomes.
    - Added new clips for the bridge game to manage game start and lost scenarios.
    [firmware.ino, gandalf.h, pet.h, pets.h]
2026-10-20 Add pet behavior checks and mood management in lotr_preview.cpp
    - Introduced a new petCheck function to validate pet states and behaviors.
    - Enhanced mood management by setting moods based on pet actions.
    - Added various pet-related events such as sleep, drink, refuse, gloat, yawn, hungry, sad, flight, and ride with corresponding behaviors.
    - Updated the main function to include petCheck and new event handlers for different weather conditions.
2026-10-20 Add game high score management and reset functionality for pets
    [firmware.ino]
2026-10-21 Update battery calibration values and enhance battery management in firmware; add gallery script for animation previews
2026-10-22 electronics: drop the PCB rev A attempt, keep a brief for the PCB designer
    [mysterychain.kicad_pcb, mysterychain.kicad_sch]
2026-10-22 showcase: seat the back cover in the housing
2026-10-22 docs: generic text-to-cad path in regenerate steps
2026-10-22 feat: add battery gauge implementation and tests
2026-10-23 fix: turn off the BLE connection LED blinking while advertising
    [firmware.ino]
2026-10-23 Add motor control functionality to firmware
    - Introduced a new motor control function to manage motor activation with a soft-start ramp.
    - Adjusted battery voltage handling for motor operation, ensuring consistent performance across varying battery levels.
    - Replaced direct digital write calls for motor control with the new motor function for better abstraction and maintainability.
    - Updated setup and loop functions to optimize power management and reduce unnecessary LED blinking during advertising.
    [firmware.ino]
2026-10-23 fix: adjust motor voltage for improved performance
    [firmware.ino]
2026-10-23 feat: implement battery level tracking and mood adjustment based on battery status
2026-10-23 feat: add builder tool for firmware and app installation with device status monitoring
2026-10-24 Remove USB-C plug design file (usb_plug.step.py) from the mechanical directory. This file contained the design specifications and generation logic for a tethered USB-C plug made from TPU, including d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
    [back_cover.3mf, back_cover.stl, chain.gcode.02.gcode.3mf, chain.gcode.03.gcode.3mf, front_housing.3mf, front_housing.stl, midframe.3mf, midframe.stl]
2026-10-24 Refactor code structure for improved readability and maintainability
    [chain.gcode.01.gcode.3mf, chain.gcode.02.gcode.3mf, chain.gcode.03.gcode.3mf, chain.gcode.04.gcode.3mf, chain.gcode.3mf]
2026-10-26 feat: enhance power management with adjustable screen off and wake settings
